naimabouk/hurudza-iot-telemetry/hardware/schematics/hurudza_schematic.pdf

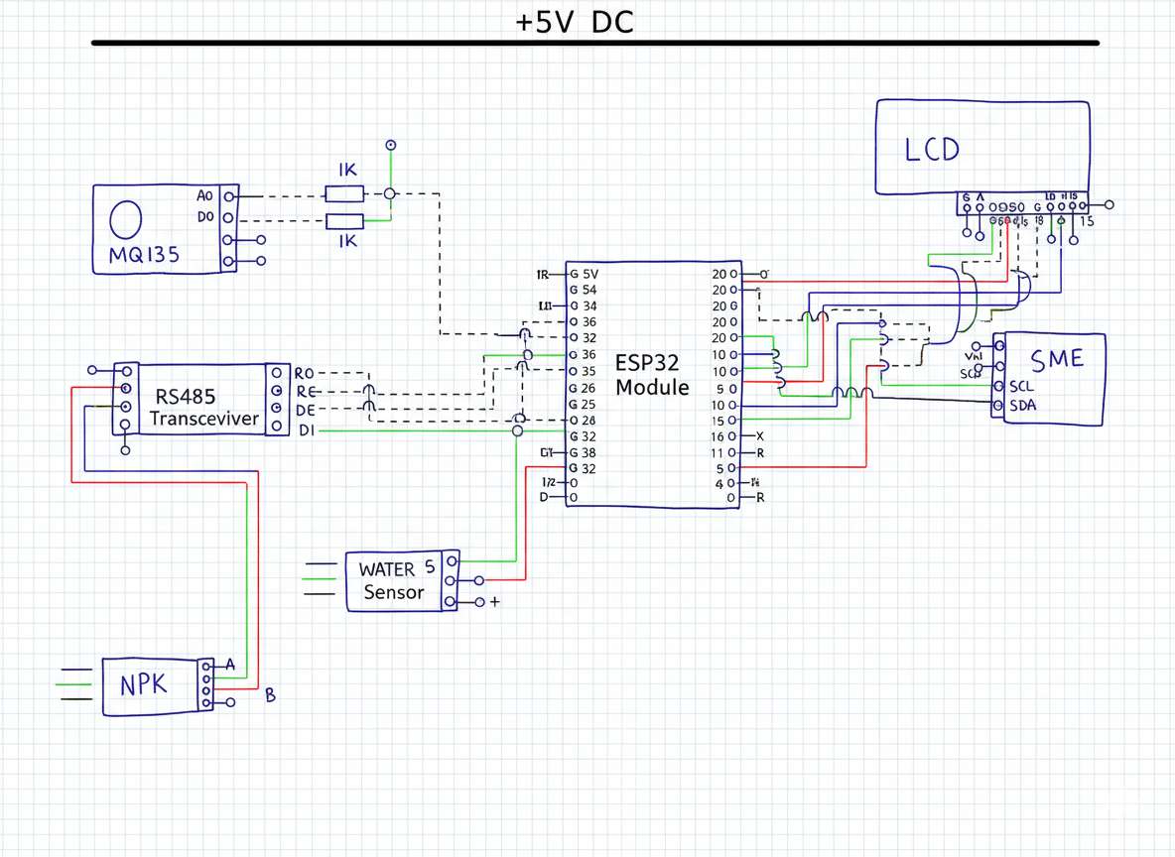
[picture p8: figure]
