naimabouk/hurudza-iot-telemetry/docs/images/scaleout_architecture.jpg

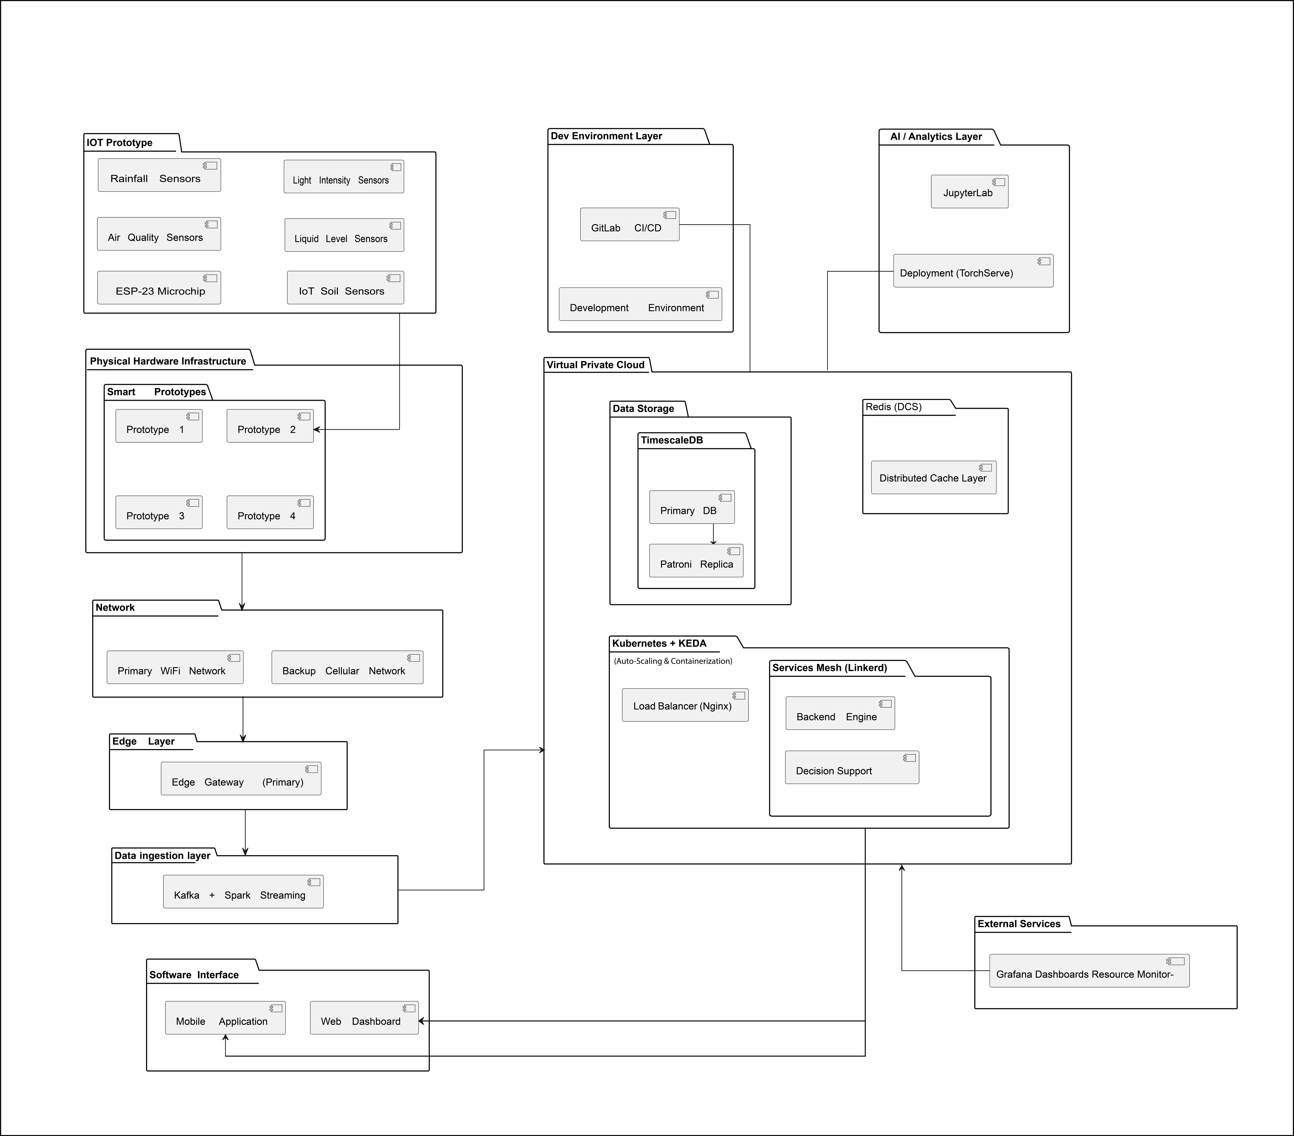
docs/images/scaleout_architecture.jpg
