naimabouk/hurudza-iot-telemetry/hardware/pcb/pcb_3d_bottom.jpg

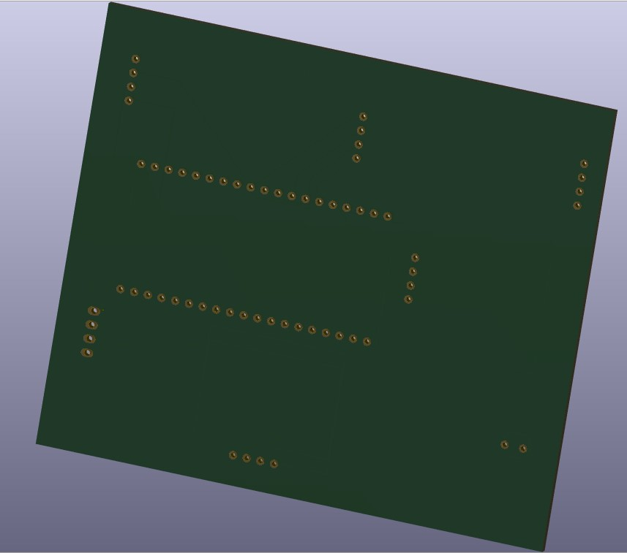
hardware/pcb/pcb_3d_bottom.jpg
