naimabouk/hurudza-iot-telemetry/firmware/hurudza/secrets.example.h

// secrets.example.h - copy this file to secrets.h and fill in your values.
// secrets.h is listed in .gitignore and must never be committed.
#pragma once

#define WIFI_SSID      "YOUR_WIFI_SSID"
#define WIFI_PASSWORD  "YOUR_WIFI_PASSWORD"

// HTTPS endpoint that accepts form-encoded telemetry (see docs/telemetry_api.md)
#define TELEMETRY_URL  "https://your-server.example/sm.php"
#define TELEMETRY_KEY  "YOUR_API_KEY"
